yuqlid/kicad_footprint/Transformer_SMD.3dshpaes/alt3232m-151.step

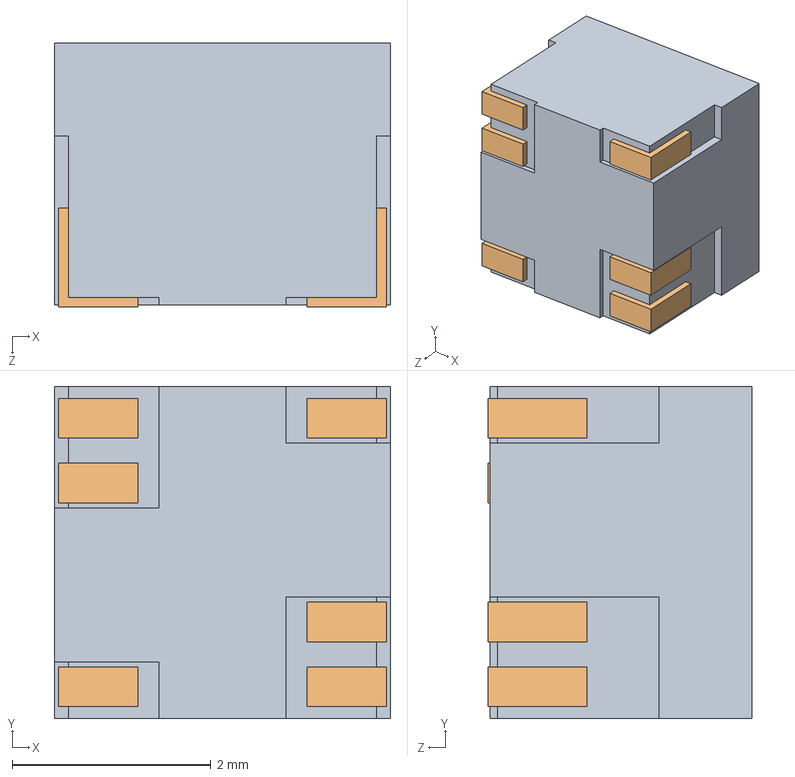
[picture p1: CAD file, 2026-08-30]
Transformer_SMD.3dshpaes/alt3232m-151.step
3.38 x 3.34 x 2.66 mm
ALT3232M-151 DRコアブロック(typ size)
ALT3232M-151 端子ブロック(typ size) x 6
