yuqlid/kicad_footprint/(commit log)

2016-04-11 サイズ少し大きくした
2016-04-21 Add BOURNS SRR4028-xxxY Choke_SMD Add PowerDI-323 Diode_SMD
2016-04-24 原点を調整
2016-07-20 めも追加
2016-07-22 追加 TE ダイナミックコネクタ D-3200S 基板取タブ・ヘッダー（水平タイプ）２P(179276)
2016-07-25 追加 TE ダイナミックコネクタ D-3500D 基板取タブ・ヘッダー（水平タイプ）4P(1376133)
2016-07-25 編集 外形線を追加
2016-07-25 追加 TE ダイナミックコネクタ D-3500D 基板取タブ・ヘッダー（水平タイプ）12P(177555) 追加 TE ダイナミックコネクタ D-3500D 基板取タブ・ヘッダー（水平タイプ）20P(175365)
2016-07-25 追加 TE ダイナミックコネクタ D-3200S 基板取タブ・ヘッダー（水平タイプ）3P(178138) 追加 TE ダイナミックコネクタ D-3200S 基板取タブ・ヘッダー（垂直タイプ）2P(917337) 追加 TE ダイナミックコネクタ D-3200S 基板取タブ・ヘッダー（垂直タイプ）3P(178136)
2016-07-25 追加 TE ダイナミックコネクタ D-5200S 基板取タブ・ヘッダー（水平タイプ）2P(353079)
2016-07-27 タグ追加
2016-09-12 追加 NDK 水晶振動子 SMD 2Pads 追加 NDK 水晶振動子 SMD 2Pads 手ハンダ用
2016-09-19 追加 JST ZHコネクタ スルーホール アングル 3,4,5P
2016-09-19 追加 TSSOP28EP
2016-09-19 追加 シャント抵抗 3921,2512
2016-09-19 追加 JST ZH_B05B-ZR-SM4-TF_05
2016-09-22 3Dモデルの座標系を変更
2016-09-22 追加 JST ZH_B03B-ZR-SM4-TF_03
2016-09-22 追加 JST ZH_B04B-ZR-SM4-TF_04
2016-09-22 追加 JST SH_BM03B-SRSS-TB_03
2016-09-22 追加 JST SH_BM04B-SRSS-TB_04
2016-09-22 追加 JST SH_BM05B-SRSS-TB_05
2016-09-22 3Dモデルを変更
2016-09-22 3Dモデルを割り当て
2016-09-22 追加 Allegro A4957用 24QFN
2016-09-22 追加 intersil HIP2104用 12DFN
2016-09-24 追加 intersil HIP2103用 8DFN
2016-09-24 追加 BOURNS用 ChokeSMD
2016-09-27 3Dモデル割り当て
2016-09-27 追加 ALPS タクトスイッチ4P SKRPAxE010
2016-12-18 信号線のパターンの幅を0.7mmから0.9mmに広げた
2017-02-02 追加 stm32 UFQFPN28
2017-02-26 追加 Allegro ACS711用QFN12
2017-02-28 追加 Allegro ACS781用PSOF-7
2017-03-23 追加 mcp16331用DFN
2017-03-26 コモンモードチョークコイルのフットプリント，0504追加
2017-03-28 RJ45_J0011D21BNL 追加 秋月でも取扱のあるパルストランス内蔵モジュラージャック LANコネクタ Rj45
2017-03-28 信号線のスルーホールを修正
2017-03-31 削除 コモンモードチョーク0504パッケージ 追加 Panasonic EXC24CN 追加 TDK MCZ1210AH 僅かにサイズが異なるので専用でフットプリント作成
2017-03-31 名前変更 4028 削除 4011,4018 サイズが4028同じなのであっても意味ないかな
2017-03-31 追加 BOURNS 4018, 4018TA, 4026
2017-04-04 追加 Molex_SPOX-5268シリーズコネクタ 22-05-7035 22-05-7045 要はDynamixelについてるコネクタ
2017-04-19 追加 フェライトビーズ 6003 0805
2017-04-19 追加 JST ZH 6P アングル
2017-04-23 シルク修正
2017-04-23 LAN9252用QFN64追加，標準のやつはEPが大きかったので少しEPを小さくして追加する
2017-04-25 追加 LQFP64-10x10mm_Pitch0.5mm_stm32 stm32の64pLQFPのフットプリントリファレンス
2017-06-20 追加 Minimax MAU10x http://akizukidenshi.com/catalog/g/gM-04131/
2017-07-23 追加 BOURNS 40182TA
2017-08-31 追加 LFPAK33(これ本当にはんだ付けできるのか？？？？)
2017-09-01 追加 Molex 52207-1133 FPCコネクタ
2017-09-02 追加 BOURNS 3015
2017-09-02 追加 テストパッド smd
2017-09-02 追加 VFQFPN48 for STSPIN32F0
2017-09-02 追加 8-FLCSP analogdevices用
2018-05-24 親フォルダ名変更
2018-05-24 追加 DLW21HN900SQ2
2018-08-10 フォルダ名変更 Connect to Connector
2018-08-10 追加 stanley 1211c
2018-08-20 フォルダ名変更
2018-08-20 NDK_Crystal_SMD_3225_2Padsの3Dモデル追加
2018-08-20 ALPSのスイッチのフォルダ名を変更
2018-08-20 LANコネクタ RJ-45 J0011D21BNLのディレクトリ変更
2018-08-23 MAU10xのフォルダ変更
2018-08-23 Add Molex micro USB connector 105017-0001 https://www.japanese.molex.com/molex/products/datasheet.jsp?part=active/1050170001_IO_CONNECTORS.xml
2018-08-23 Add microSD connector https://www.hirose.com/product/en/products/DM3/DM3AT-SF-PEJM5/
2018-08-30 コネクタ XT30PW-M追加
2018-08-30 コネクタ XT30PW-W 追加 フットプリントのシルクはまだ調整が必要
2018-08-30 シルクを修正
2018-09-03 追加 Bornsのリセッタブルヒューズ
2018-09-03 追加 Abraconの水晶
2018-09-07 KiCadのライブラリに準拠し，＋→1，-→2に変更した
2019-05-11 RECOMの絶縁DCDCコンバータ追加
2020-02-23 Omegaの熱電対用コネクタ追加
2020-02-23 DCDCコンバータ追加
2022-01-09 EPOS4用ピンソケット追加，ミラー注意
2022-12-24 MPSのQFN-26追加
2023-01-23 ムラタのDCDC追加
2026-08-16 M5Stamp-pico追加
2026-08-16 CodeXにISP作らせた、これから修正入るかも
2026-08-30 座標ミスするポカ修正
2026-08-30 色々追加
    [alt3232m-151.step]
